Hgerbrandt/mini-pcb/docs/img/poster.png

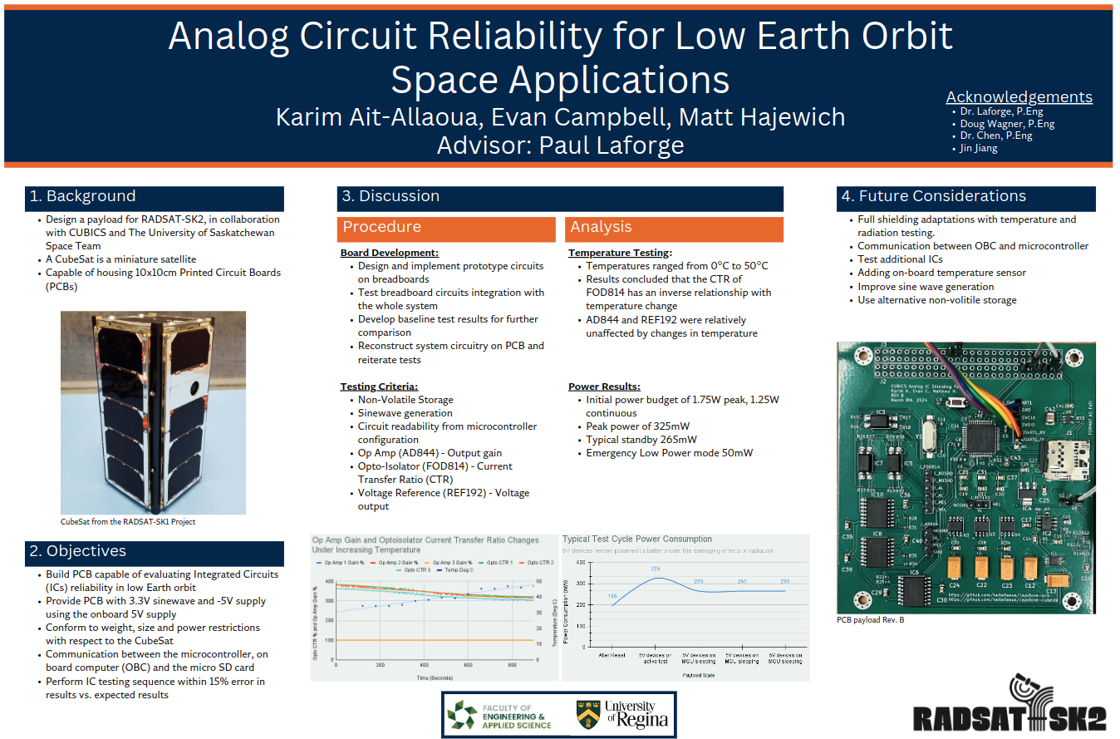
docs/img/poster.png
