Hgerbrandt/mini-pcb/docs/img/back_pcb.png

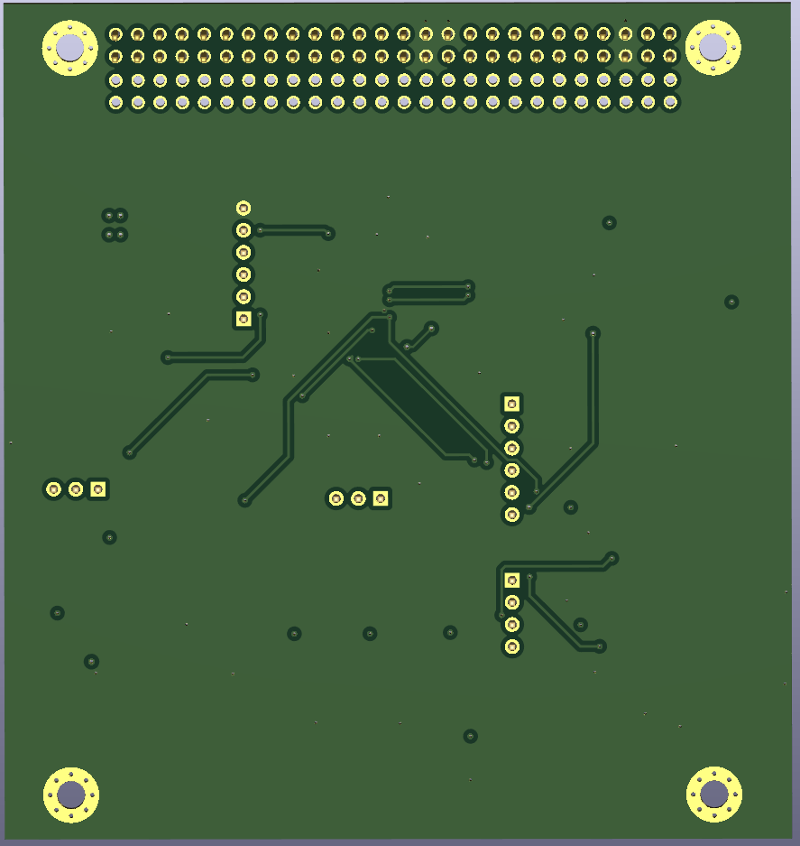
docs/img/back_pcb.png
