Hgerbrandt/mini-pcb/docs/img/front_cu.png

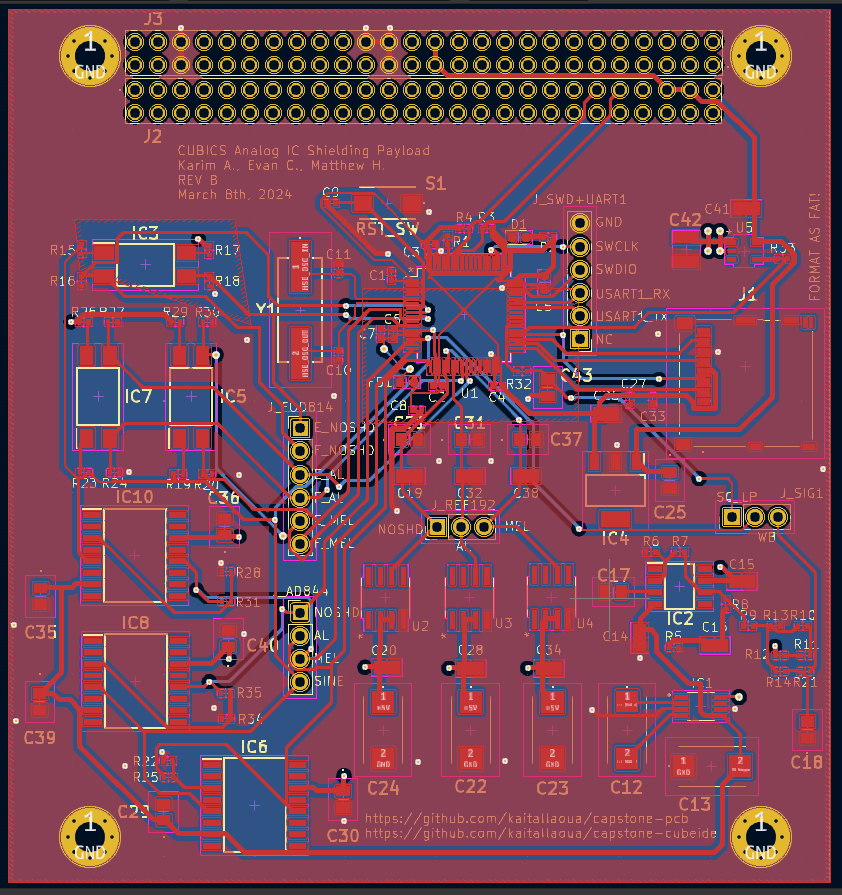
docs/img/front_cu.png
