Hgerbrandt/mini-pcb/docs/img/front_pcb.png

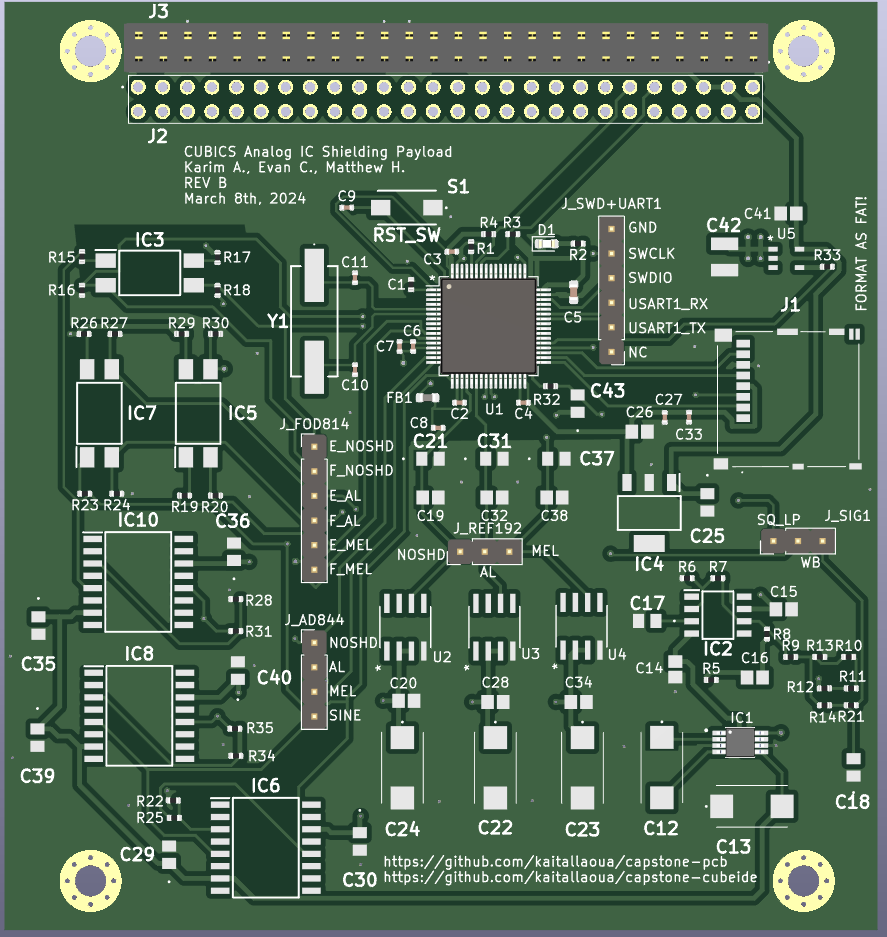
docs/img/front_pcb.png
