Hgerbrandt/mini-pcb/docs/BOM Initial PCB Design - 1st order.pdf

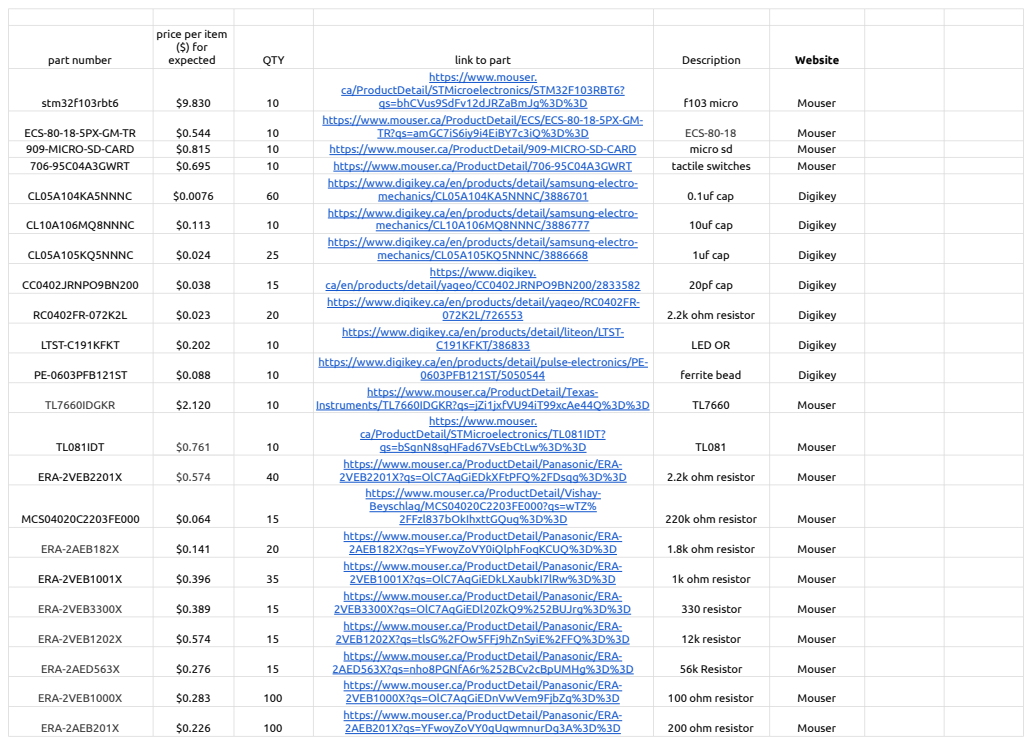
[picture p5: page 1]
part number; QTY; link to part; Description; Website; stm32f103rbt6; qs=bhCVus9SdFv12dJRZaBmJg%3D%3D; f103 micro; Mouser; ECS-80-18-5PX-GM-TR; TR?qs=amGC7iS6iy9i4EiBY7c3iQ%3D%3D; ECS-80-18; 909-MICRO-SD-CARD; https://www.mouser.ca/ProductDetail/909-MICRO-SD-CARD; micro sd; 706-95C04A3GWRT; https://www.mouser.ca/ProductDetail/706-95C04A3GWRT; tactile switches; CL05A104KA5NNNC; mechanics/CL05A104KA5NNNC/3886701; 0.1uf cap; Digikey; CL10A106MQ8NNNC; mechanics/CL10A106MQ8NNNC/3886777; 10uf cap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

price per item
($) for
expected

https://www.mouser.

ca/ProductDetail/STMicroelectronics/STM32F103RBT6?

https://www.mouser.ca/ProductDetail/ECS/ECS-80-18-5PX-GM-

https://www.digikey.ca/en/products/detail/samsung-electro-

https://www.digikey.

https://www.digikey.ca/en/products/detail/yageo/RC0402FR-

https://www.digikey.ca/en/products/detail/liteon/LTST-

https://www.digikey.ca/en/products/detail/pulse-electronics/PE-

https://www.mouser.ca/ProductDetail/Texas-

ca/ProductDetail/STMicroelectronics/TL081IDT?

https://www.mouser.ca/ProductDetail/Panasonic/ERA-
https://www.mouser.ca/ProductDetail/Vishay-
Beyschlag/MCS04020C2203FE000?qs=wTZ%

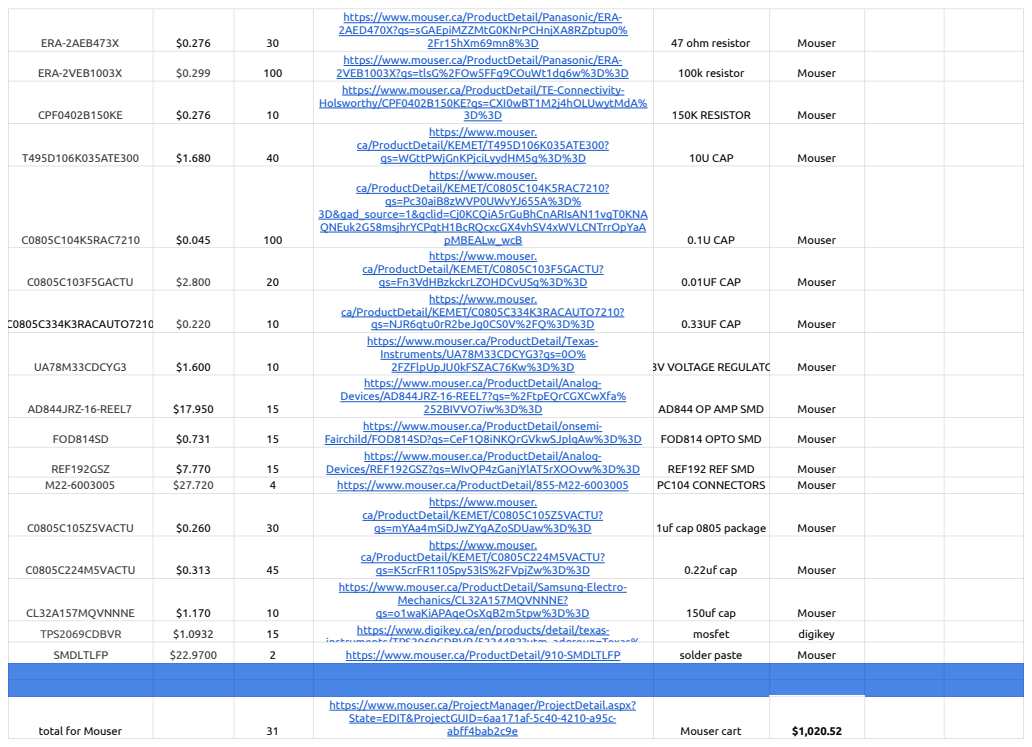
[picture p6: page 2]
ERA-2AEB473X; 2Fr15hXm69mn8%3D; 47 ohm resistor; Mouser; ERA-2VEB1003X; 2VEB1003X?qs=tlsG%2FOw5FFg9COuWt1dq6w%3D%3D; 100k resistor; CPF0402B150KE; 150K RESISTOR; T495D106K035ATE300; qs=WGttPWjGnKPjciLyydHM5g%3D%3D; 10U CAP; C0805C104K5RAC7210; 3D&gad_source=1&gclid=Cj0KCQiA5rGuBhCnARIsAN11vgT0KNA QNEuk2G58msjhrYCPqtH1BcRQcxcGX4vhSV4xWVLCNTrrOpYaA; pMBEALw_wcB; 0.1U CAP; C0805C103F5GACTU; qs=Fn3VdHBzkckrLZOHDCvUSg%3D%3D; 0.01UF CAP; C0805C334K3RACAUTO7210; qs=NJR6qtu0rR2beJg0CS0V%2FQ%3D%3D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

https://www.mouser.ca/ProductDetail/Panasonic/ERA-
2AED470X?qs=sGAEpiMZZMtG0KNrPCHnjXA8RZptup0%

https://www.mouser.ca/ProductDetail/TE-Connectivity-
Holsworthy/CPF0402B150KE?qs=CXI0wBT1M2j4hOLUwytMdA%

https://www.mouser.

ca/ProductDetail/KEMET/T495D106K035ATE300?

ca/ProductDetail/KEMET/C0805C104K5RAC7210?
qs=Pc30aiB8zWVP0UWvYJ655A%3D%

ca/ProductDetail/KEMET/C0805C103F5GACTU?

ca/ProductDetail/KEMET/C0805C334K3RACAUTO7210?
https://www.mouser.ca/ProductDetail/Texas-
Instruments/UA78M33CDCYG3?qs=0O%
https://www.mouser.ca/ProductDetail/Analog-
Devices/AD844JRZ-16-REEL7?qs=%2FtpEQrCGXCwXfa%

https://www.mouser.ca/ProductDetail/onsemi-

ca/ProductDetail/KEMET/C0805C105Z5VACTU?

ca/ProductDetail/KEMET/C0805C224M5VACTU?

https://www.mouser.ca/ProductDetail/Samsung-Electro-

https://www.mouser.ca/ProjectManager/ProjectDetail.aspx?
State=EDIT&ProjectGUID=6aa171af-5c40-4210-a95c-

total for Digikey | 8 | https://www.digikey.ca/short/bmjnbp47 | Digikey cart | 33.18
total cart | 39 | TOTAL | $1,053.70 | Tax might not | be included

https://www.mouser.
ca/ProductDetail/KEMET/C0805C334K3RACAUTO?
qs=sSYV1F9c5cFAGgBePUAC4A%3D%3D (https://www.mouser.ca/ProductDetail/KEMET/C0805C334K3RACAUTO?qs=sSYV1F9c5cFAGgBePUAC4A%3D%3D) | .33uf new
