Hgerbrandt/mini-pcb/footprint_3d/TL7660IDGKR.step

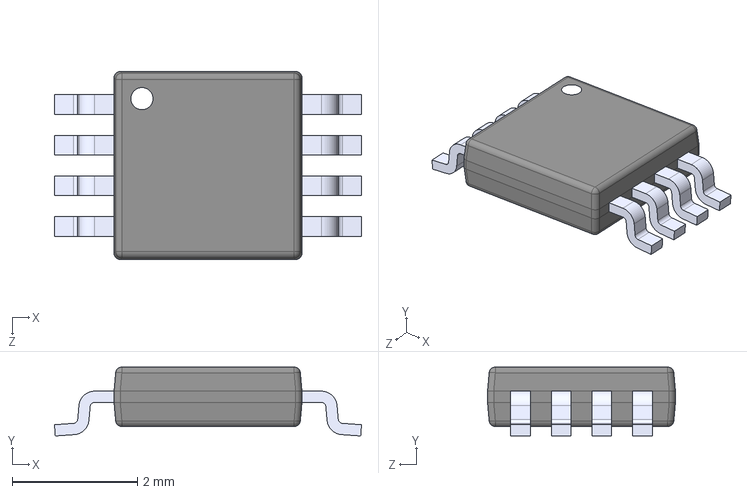
[picture p7: CAD file, 2025-03-23]
footprint_3d/TL7660IDGKR.step
4.90 x 1.10 x 3.00 mm
