Hgerbrandt/mini-pcb/footprint_3d/DBV0005A-MF.stp

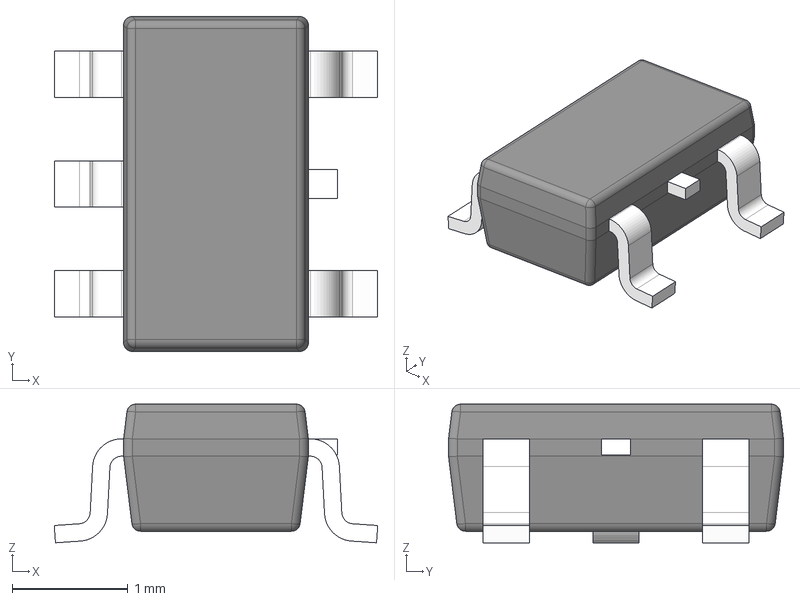
[picture p8: CAD file, 2025-03-23]
footprint_3d/DBV0005A-MF.stp
2.80 x 2.90 x 1.20 mm
BODY-SOT
LEAD-SOT x 5
LEAD-DUMMY
