Hgerbrandt/mini-pcb/footprint_3d/TL081IDT.stp

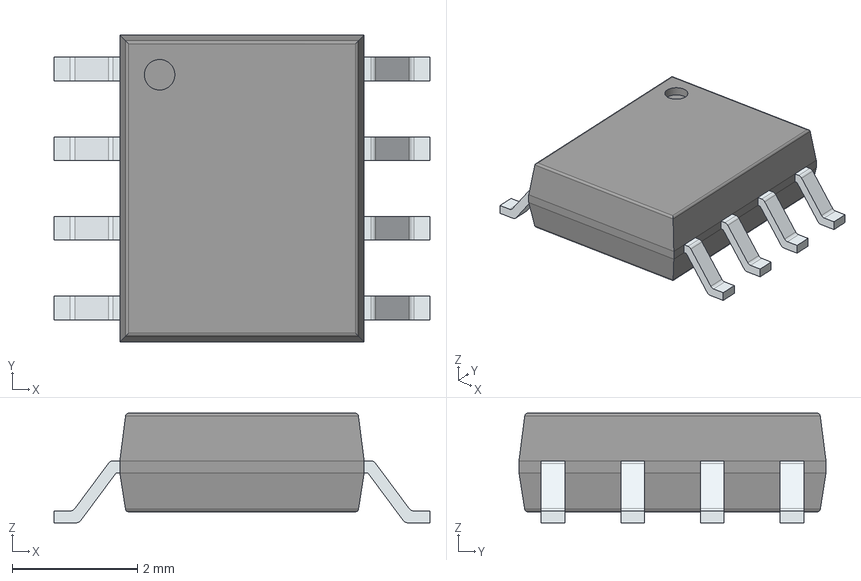
[picture p9: CAD file, 2025-03-23]
footprint_3d/TL081IDT.stp
6.00 x 4.90 x 1.75 mm
PinsArrayLR
