Hgerbrandt/mini-pcb/footprint_3d/ECS-80-18-5PX-GM-TR.stp

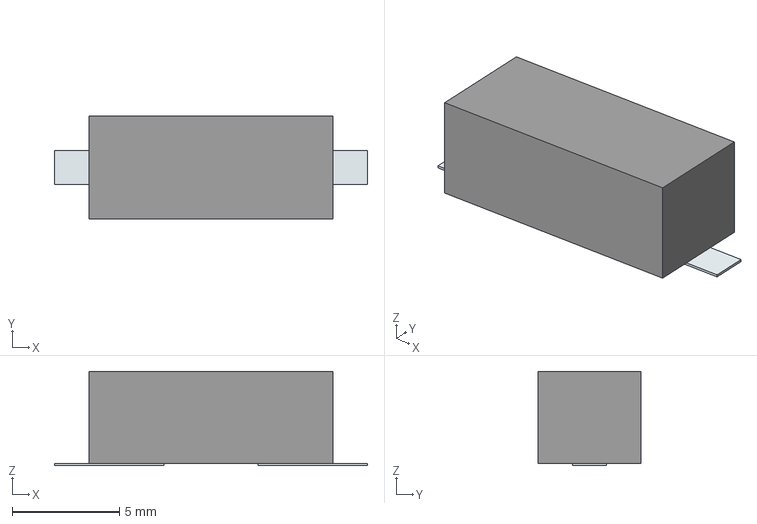
[picture p10: CAD file, 2025-03-23]
footprint_3d/ECS-80-18-5PX-GM-TR.stp
14.6 x 4.80 x 4.40 mm
Pins
