Hgerbrandt/mini-pcb/footprint_3d/MS128-10C.step

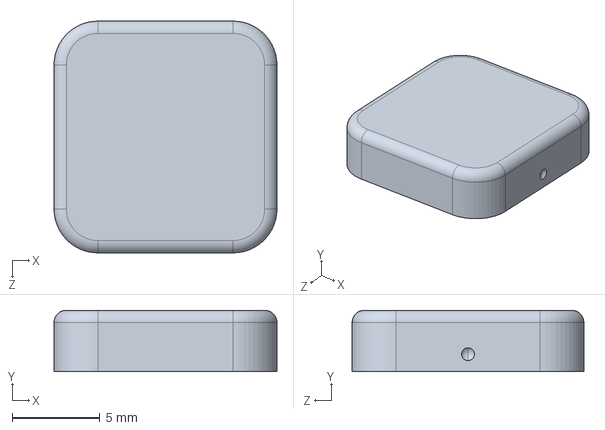
[picture p11: CAD file, 2025-03-23]
footprint_3d/MS128-10C.step
12.7 x 3.50 x 13.2 mm
