Hgerbrandt/mini-pcb/footprint_3d/CAPC220145_88N_KEM.step

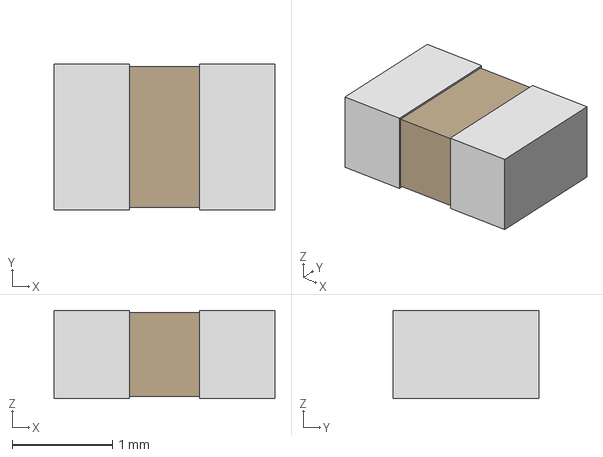
[picture p12: CAD file, 2025-03-23]
footprint_3d/CAPC220145_88N_KEM.step
2.20 x 1.45 x 0.88 mm
