Hgerbrandt/mini-pcb/footprint_3d/ESQ-126-39-L-D.stp

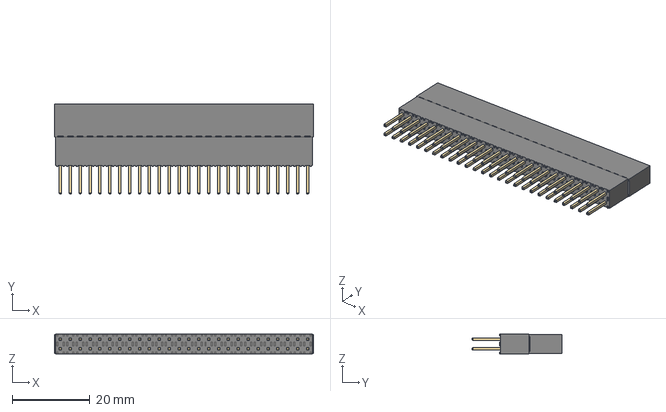
[picture p13: CAD file, 2025-03-23]
footprint_3d/ESQ-126-39-L-D.stp
66.5 x 23.2 x 5.08 mm
