Hgerbrandt/mini-pcb/footprint_3d/T495X106K050ATE250-10u.stp

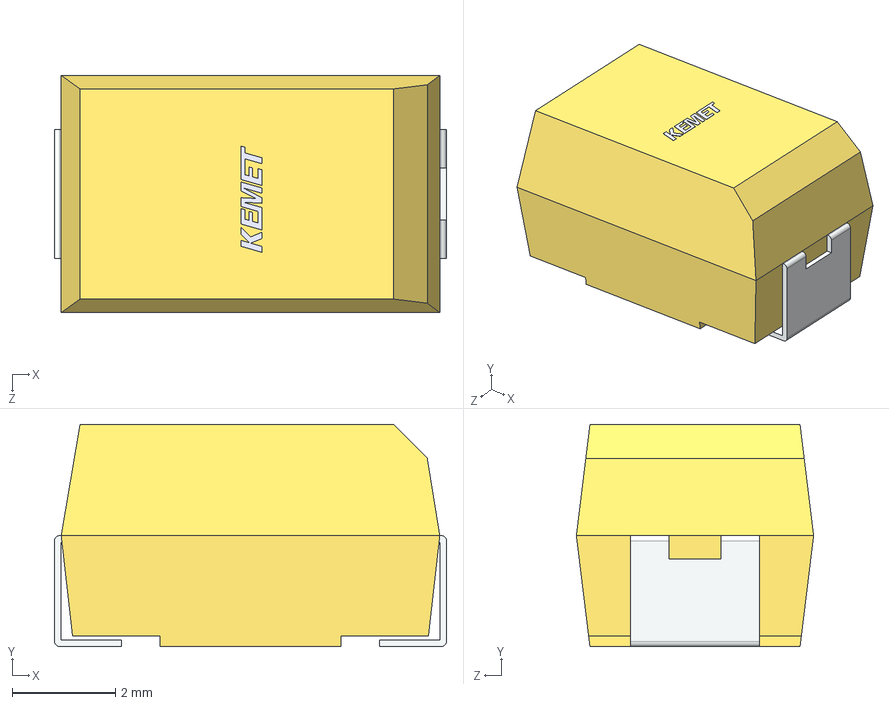
[picture p14: CAD file, 2025-03-23]
footprint_3d/T495X106K050ATE250-10u.stp
7.60 x 4.31 x 4.60 mm
