Hgerbrandt/mini-pcb/footprint_3d/LM35DM.stp

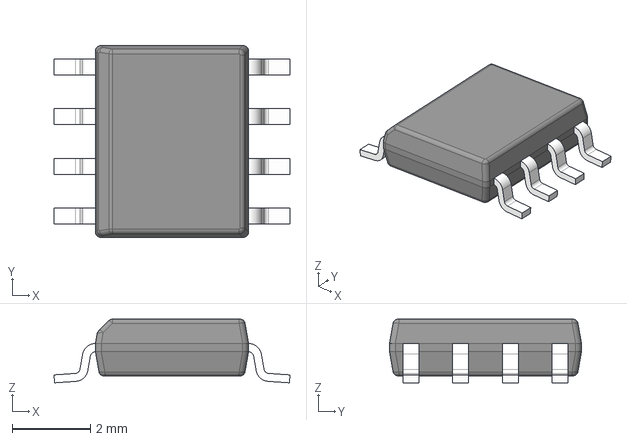
[picture p15: CAD file, 2025-03-23]
footprint_3d/LM35DM.stp
6.02 x 4.90 x 1.63 mm
BODY-SO
LEAD-D0008A x 8
