Hgerbrandt/mini-pcb/footprint_3d/C0805C224M5VACTU-0.22u.stp

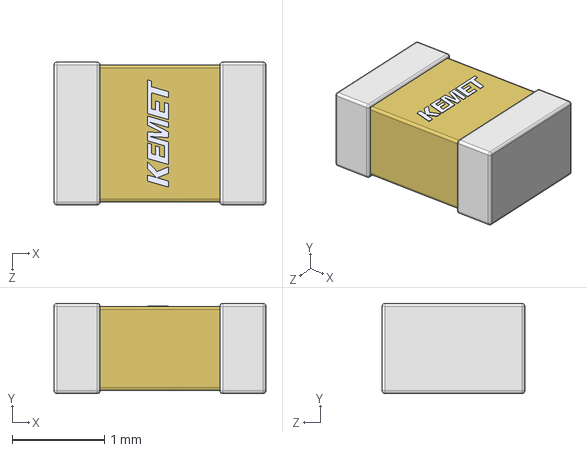
[picture p16: CAD file, 2025-03-23]
footprint_3d/C0805C224M5VACTU-0.22u.stp
2.30 x 0.98 x 1.55 mm
