Hgerbrandt/mini-pcb/footprint_3d/T495D106K035ATE300.stp

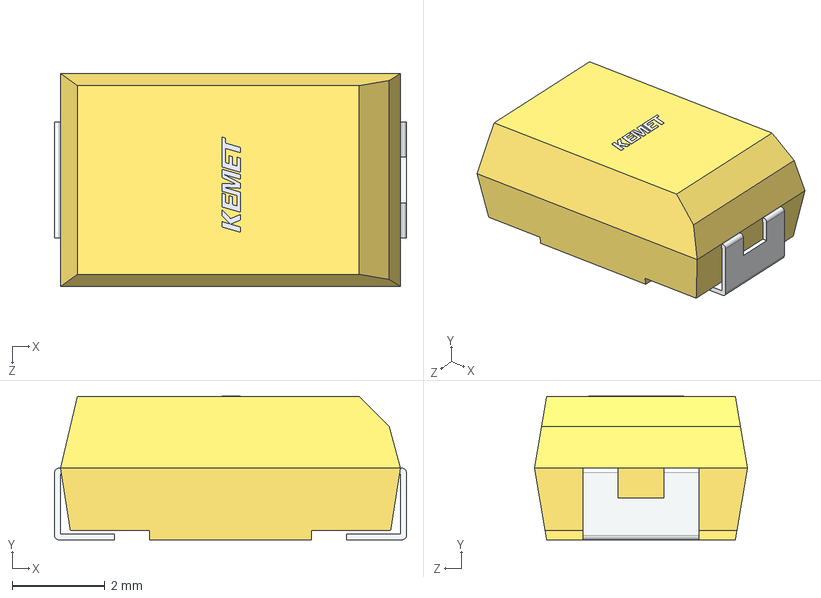
[picture p17: CAD file, 2025-03-23]
footprint_3d/T495D106K035ATE300.stp
7.60 x 3.11 x 4.60 mm
