Hgerbrandt/mini-pcb/footprint_3d/AD844ANZ.stp

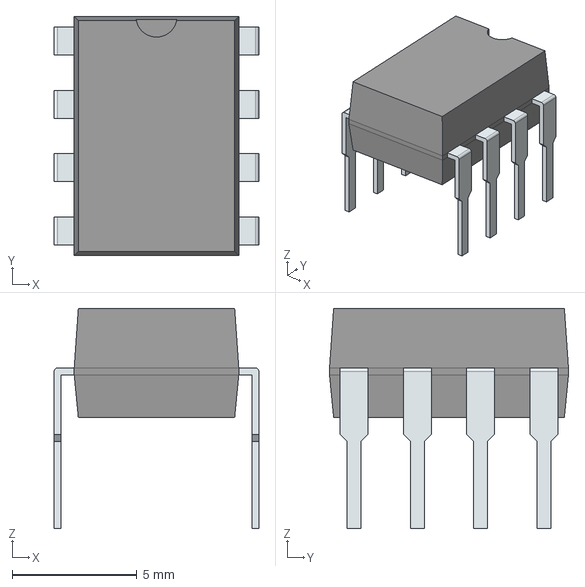
[picture p18: CAD file, 2025-03-23]
footprint_3d/AD844ANZ.stp
8.22 x 9.59 x 8.83 mm
PinsArrayLR
