Hgerbrandt/mini-pcb/footprint_3d/DM3BT_DSF_PEJS.stp

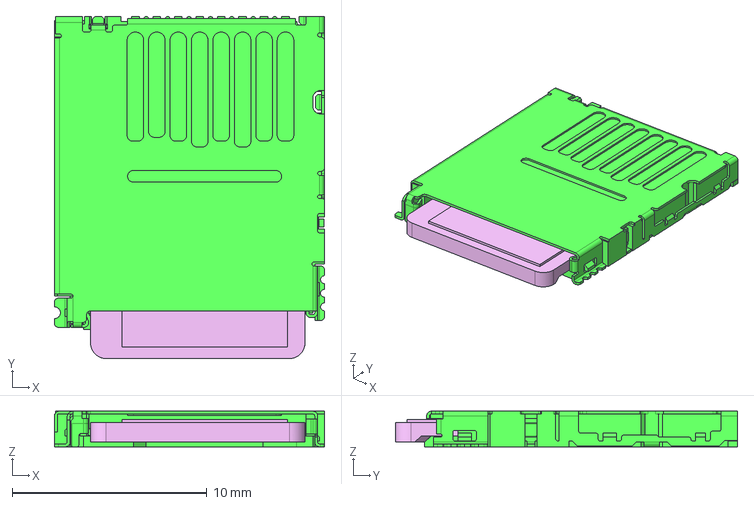
[picture p19: CAD file, 2025-03-23]
footprint_3d/DM3BT_DSF_PEJS.stp
13.8 x 17.6 x 1.83 mm
CARD
DM3BT
