Hgerbrandt/mini-pcb/footprint_3d/C0805C103F5GACTU.stp

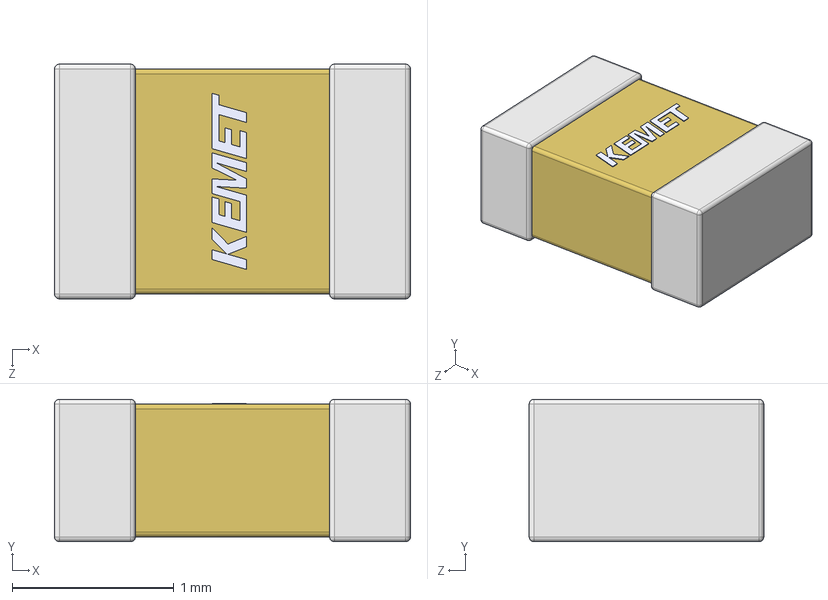
[picture p20: CAD file, 2025-03-23]
footprint_3d/C0805C103F5GACTU.stp
2.20 x 0.88 x 1.45 mm
