Hgerbrandt/mini-pcb/footprint_3d/FOD814SD.stp

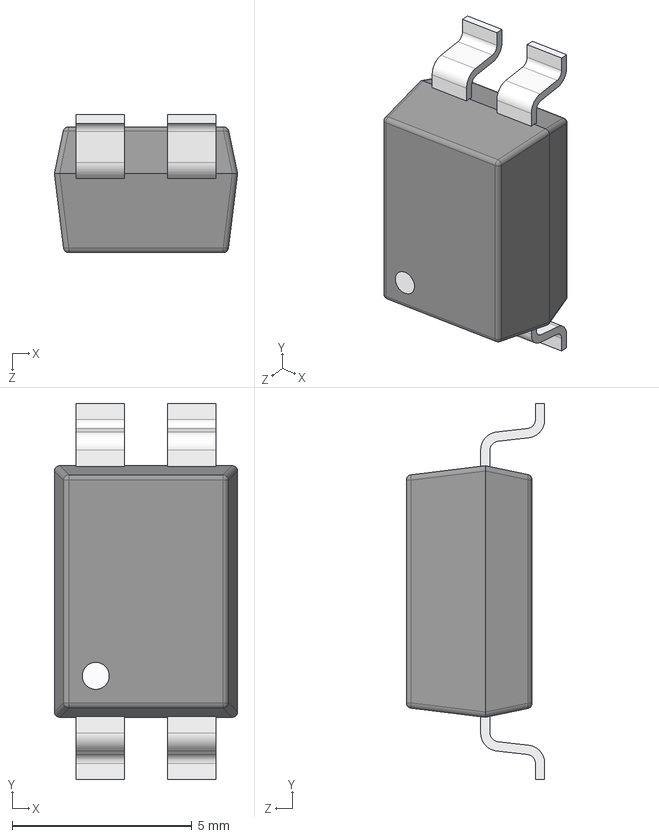
[picture p21: CAD file, 2025-03-23]
footprint_3d/FOD814SD.stp
5.10 x 10.5 x 3.85 mm
