Hgerbrandt/mini-pcb/(list of files, cad)

Other CAD files:
footprint_3d/REF192GSZ.step
