Hgerbrandt/mini-pcb/pcb/mcu_integration.kicad_pcb

## KiCad design pcb/mcu_integration.kicad_pcb (2026-03-15)

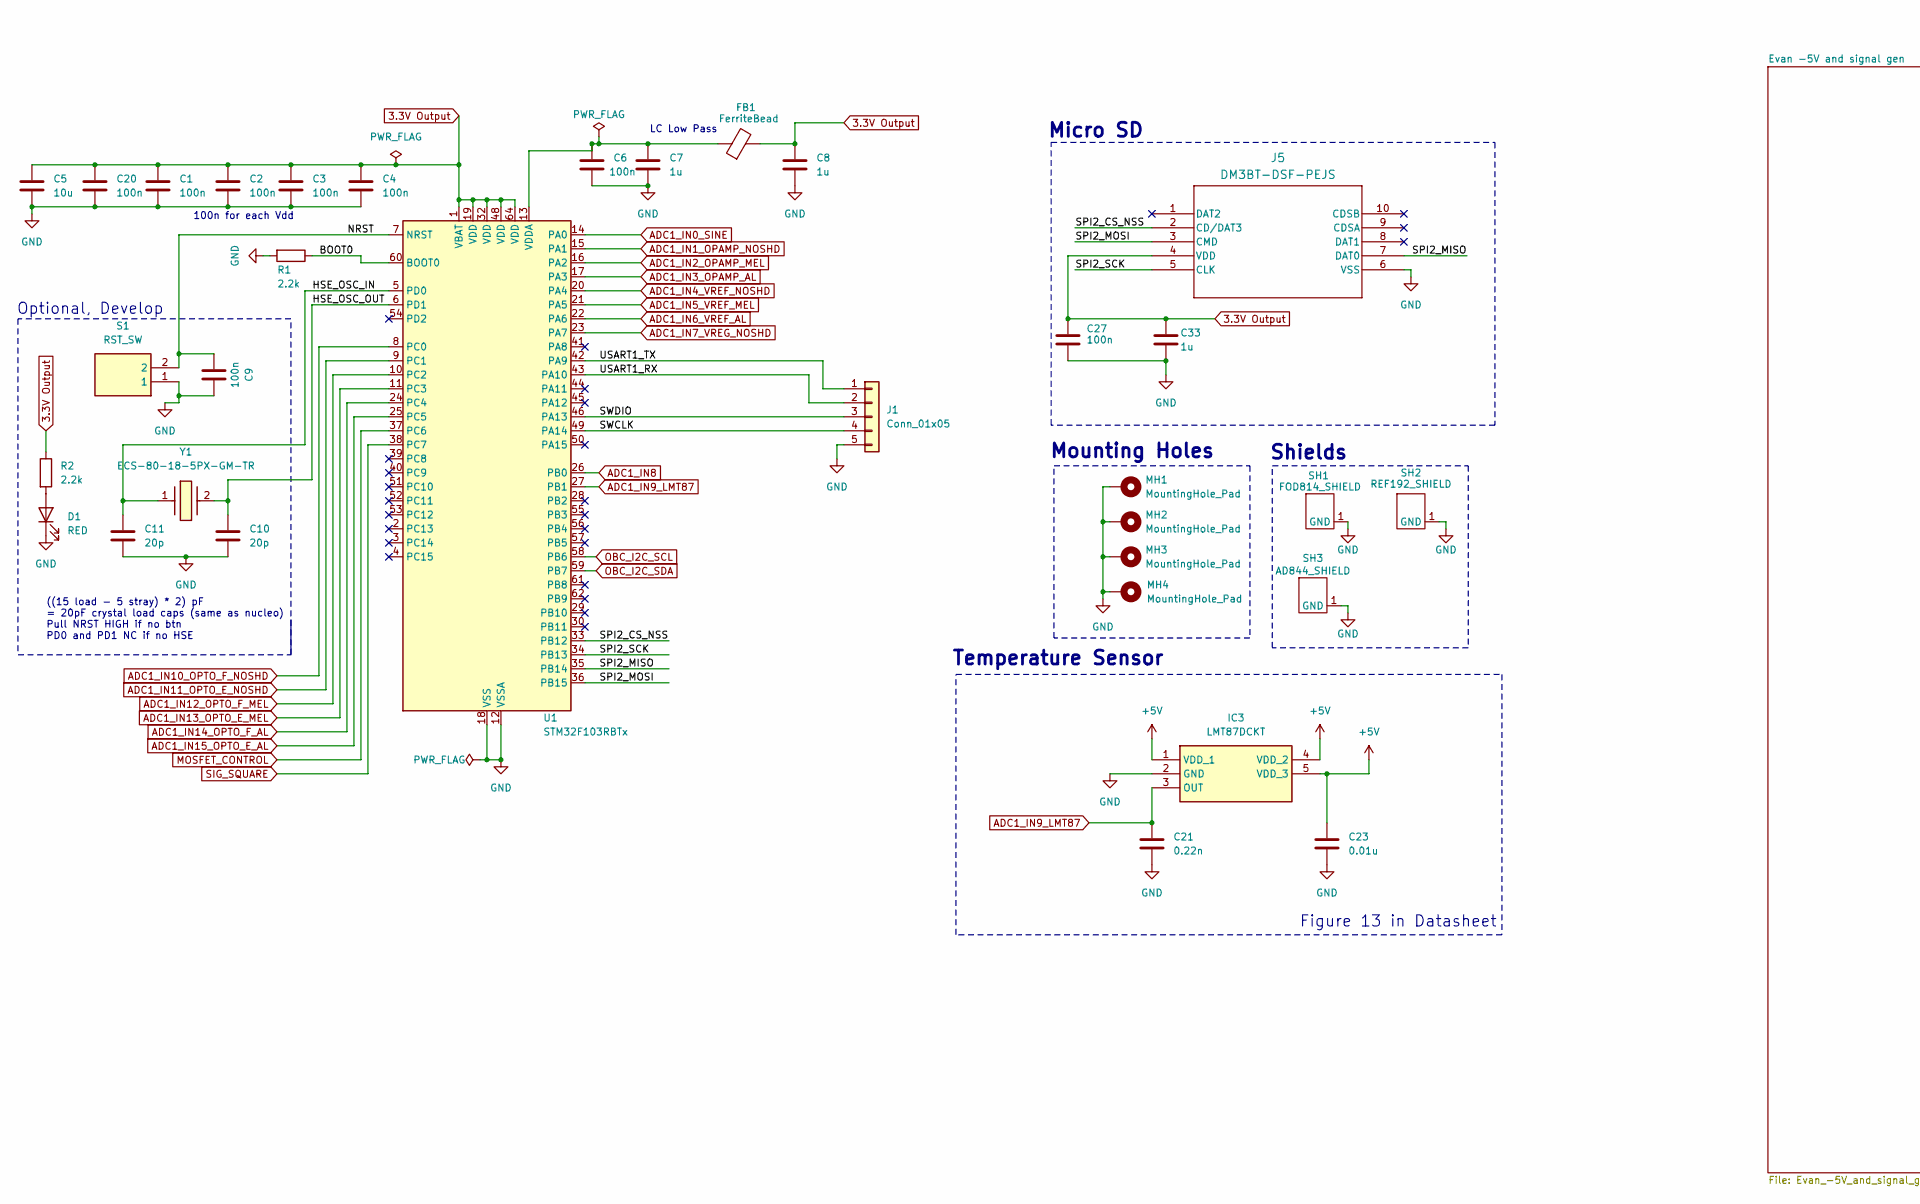
[picture p22: schematic mcu_integration.kicad_sch, Regina Payload Cubesat MCU Integration, part in row 1, column 1]

Parts:
C1, C2, C3, C4, C6, C9, C20, C27: 100n; C_0402_1005Metric
C5: 10u; C_0603_1608Metric
C7, C8, C33: 1u; C_0402_1005Metric
C10, C11: 20p; C_0402_1005Metric
C21: 0.22n; C_0402_1005Metric
C23: 0.01u; C_0402_1005Metric
D1: RED; LED_0603_1608Metric
FB1: FerriteBead; L_0603_1608Metric
IC3: LMT87DCKT; SOT65P210X110-5N; Mouser Part Number 595-LMT87DCKT
J1: Conn_01x05; PinHeader_1x05_P2.54mm_Vertical
J5: DM3BT-DSF-PEJS; DM3BT_DSF_PEJS
MH1, MH2, MH3, MH4: MountingHole_Pad; MountingHole_3.18mm_6.35mm_Pad
R1, R2: 2.2k; R_0402_1005Metric
S1: RST_SW; 95C04A3GWRT; Mouser Part Number 706-95C04A3GWRT
SH1: FOD814_SHIELD; FOD814 Shield
SH2: REF192_SHIELD; REF192 Shield
SH3: AD844_SHIELD; AD844 Shield
U1: STM32F103RBTx; LQFP-64_10x10mm_P0.5mm
Y1: ECS-80-18-5PX-GM-TR; ECS80185PXGMTR; Mouser Part Number 520-80-18-5PX-GM-TR

Connections:
3.3V Output: C1.1, C2.1, C3.1, C4.1, C5.1, C8.1, C20.1, C27.1, C33.1, FB1.2, J5.4 (VDD), R2.1, U1.1 (VBAT), U1.19 (VDD), U1.32 (VDD), U1.48 (VDD), U1.64 (VDD); also elsewhere on the board
+5V: C23.1, IC3.1 (VDD_1), IC3.4 (VDD_2), IC3.5 (VDD_3); also elsewhere on the board
/BOOT0: R1.1, U1.60 (BOOT0)
/HSE_OSC_IN: C11.1, U1.5 (PD0), Y1.1
/HSE_OSC_OUT: C10.1, U1.6 (PD1), Y1.2
/NRST: C9.2, S1.2, U1.7 (NRST)
/SPI2_CS_NSS: J5.2 (CD/DAT3), U1.33 (PB12)
/SPI2_MISO: J5.7 (DAT0), U1.35 (PB14)
/SPI2_MOSI: J5.3 (CMD), U1.36 (PB15)
/SPI2_SCK: J5.5 (CLK), U1.34 (PB13)
/SWCLK: J1.4, U1.49 (PA14)
/SWDIO: J1.3, U1.46 (PA13)
/USART1_RX: J1.2, U1.43 (PA10)
/USART1_TX: J1.1, U1.42 (PA9)
ADC1_IN0_SINE: U1.14 (PA0); also elsewhere on the board
ADC1_IN1_OPAMP_NOSHD: U1.15 (PA1)
ADC1_IN2_OPAMP_MEL: U1.16 (PA2)
ADC1_IN3_OPAMP_AL: U1.17 (PA3); also elsewhere on the board
ADC1_IN4_VREF_NOSHD: U1.20 (PA4)
ADC1_IN5_VREF_MEL: U1.21 (PA5)
ADC1_IN6_VREF_AL: U1.22 (PA6); also elsewhere on the board
ADC1_IN7_VREG_NOSHD: U1.23 (PA7)
ADC1_IN8: U1.26 (PB0)
ADC1_IN9_LMT87: C21.1, IC3.3 (OUT), U1.27 (PB1)
ADC1_IN10_OPTO_F_NOSHD: U1.8 (PC0)
ADC1_IN11_OPTO_E_NOSHD: U1.9 (PC1)
ADC1_IN12_OPTO_F_MEL: U1.10 (PC2)
ADC1_IN13_OPTO_E_MEL: U1.11 (PC3)
ADC1_IN14_OPTO_F_AL: U1.24 (PC4); also elsewhere on the board
ADC1_IN15_OPTO_E_AL: U1.25 (PC5); also elsewhere on the board
GND: C1.2, C2.2, C3.2, C4.2, C5.2, C6.2, C7.2, C8.2, C9.1, C10.2, C11.2, C20.2, C21.2, C23.2, C27.2, C33.2, D1.1 (K), IC3.2 (GND), J1.5, J5.6 (VSS), MH1.1, MH2.1, MH3.1, MH4.1, R1.2, S1.1, SH1.1 (GND), SH2.1 (GND), SH3.1 (GND), U1.12 (VSSA), U1.18 (VSS), U1.31 (VSS), U1.47 (VSS), U1.63 (VSS); also elsewhere on the board
MOSFET_CONTROL: U1.37 (PC6)
unnamed: D1.2 (A), R2.2
unnamed: C6.1, C7.1, FB1.1, U1.13 (VDDA)
OBC_I2C_SCL: U1.58 (PB6); also elsewhere on the board
OBC_I2C_SDA: U1.59 (PB7); also elsewhere on the board
SIG_SQUARE: U1.38 (PC7); also elsewhere on the board

Notes on the sheet:
((15 load - 5 stray) * 2) pF = 20pF crystal load caps (same as nucleo) Pull NRST HIGH if no btn PD0 and PD1 NC if no HSE
Mounting Holes
Micro SD
Optional, Develop
Temperature Sensor
100n for each Vdd
Shields
Figure 13 in Datasheet
LC Low Pass

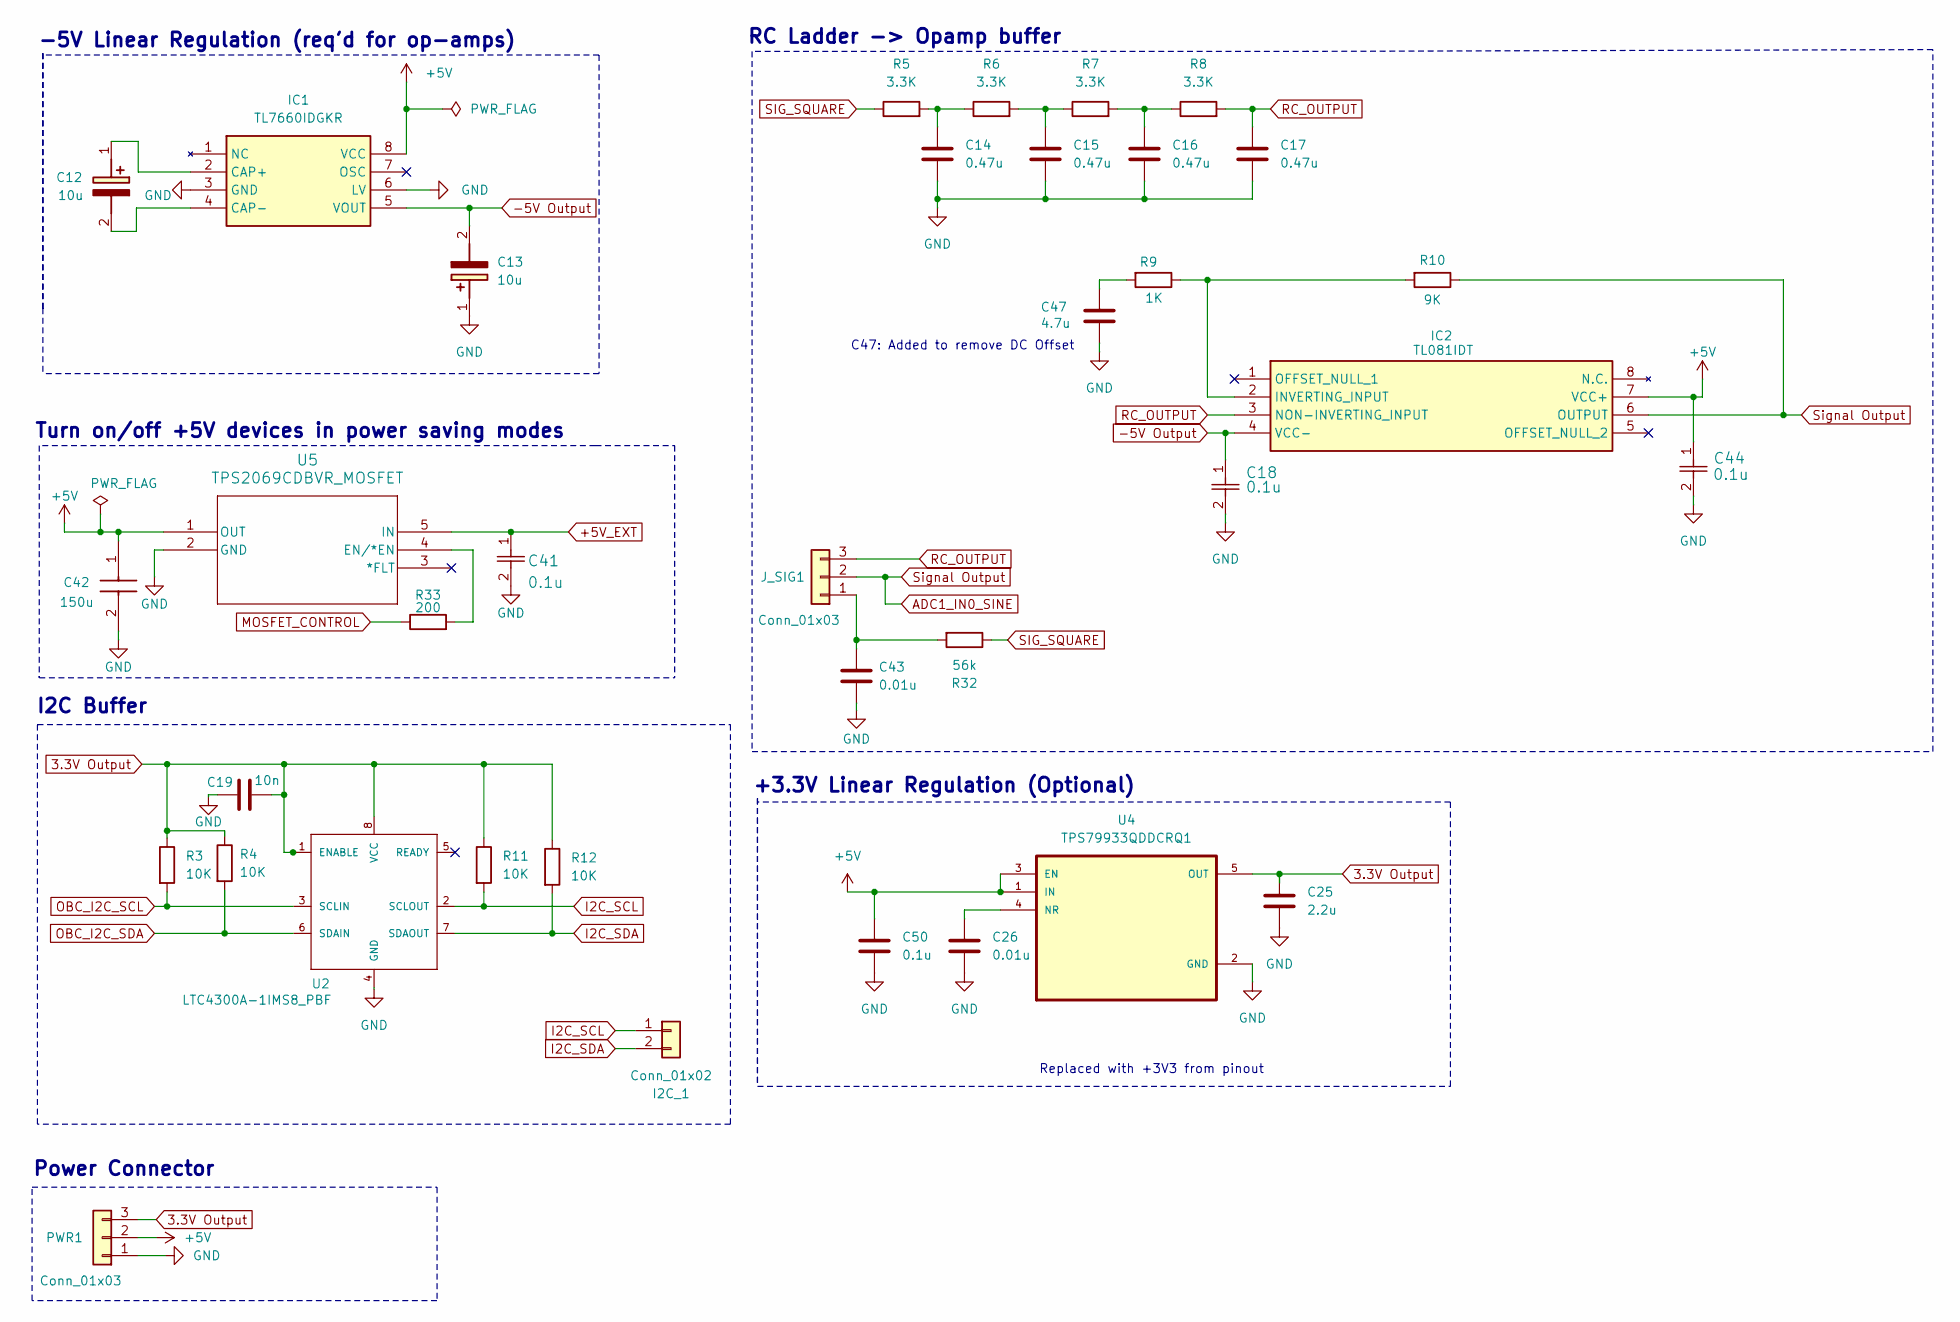
[picture p23: schematic Evan_-5V_and_signal_gen.kicad_sch, Power and Sine Generator]

Parts:
C12, C13: 10u; C_0805_2012Metric; Mouser Part Number 80-T495D106K035
C14, C15, C16, C17: 0.47u; C_0402_1005Metric
C18: 0.1u; C_0805_2012Metric
C19: 10n; C_0402_1005Metric
C25: 2.2u; C_0402_1005Metric
C26, C43: 0.01u; C_0402_1005Metric
C41, C44: 0.1u; CAPC220145_88N_KEM-0.1u
C42: 150u; CAPC3225X280N_150U; Mouser Part Number 187-CL32A157MQVNNNE
C47: 4.7u; C_0402_1005Metric
C50: 0.1u; C_0402_1005Metric
I2C_1: Conn_01x02; PinHeader_1x02_P2.54mm_Vertical
IC1: TL7660IDGKR; SOP65P490X110-8N-actual; Mouser Part Number 595-TL7660IDGKR
IC2: TL081IDT; SOIC127P600X175-8N; Mouser Part Number 511-TL081IDT
J_SIG1: Conn_01x03; PinHeader_1x03_P2.54mm_Vertical
PWR1: Conn_01x03; PinHeader_1x03_P2.54mm_Vertical
R3, R4, R11, R12: 10K; R_0402_1005Metric
R5, R6, R7, R8: 3.3K; R_0402_1005Metric
R9: 1K; R_0402_1005Metric
R10: 9K; R_0402_1005Metric
R32: 56k; R_0402_1005Metric
R33: 200; R_0402_1005Metric
U2: LTC4300A-1IMS8_PBF; MANUFACTURER_PART_NUMBER ltc4300a1ims8
U4: TPS79933QDDCRQ1; SOT95P280X110-5N
U5: TPS2069CDBVR_MOSFET; DBV5_TEX_MF

Connections:
3.3V Output: C19.2, C25.1, PWR1.3, R3.1, R4.1, R11.1, R12.1, U2.1 (ENABLE), U2.8 (VCC), U4.5 (OUT); also elsewhere on the board
+5V: C42.1, C44.1, C50.1, IC1.8 (VCC), IC2.7 (VCC+), PWR1.2, U4.1 (IN), U4.3 (EN), U5.1 (OUT); also elsewhere on the board
-5V Output: C13.2 (-), C18.1, IC1.5 (VOUT), IC2.4 (VCC-); also elsewhere on the board
ADC1_IN0_SINE: IC2.6 (OUTPUT), J_SIG1.2, R10.1; also elsewhere on the board
GND: C13.1 (+), C14.2, C15.2, C16.2, C17.2, C18.2, C19.1, C25.2, C26.2, C41.2, C42.2, C43.1, C44.2, C47.2, C50.2, IC1.3 (GND), IC1.6 (LV), PWR1.1, U2.4 (GND), U4.2 (GND), U5.2 (GND); also elsewhere on the board
I2C_SCL: I2C_1.1, R11.2, U2.2 (SCLOUT)
I2C_SDA: I2C_1.2, R12.2, U2.7 (SDAOUT)
unnamed: C12.1 (+), IC1.2 (CAP+)
unnamed: C12.2 (-), IC1.4 (CAP-)
unnamed: C14.1, R5.2, R6.1
unnamed: C15.1, R6.2, R7.1
unnamed: C16.1, R7.2, R8.1
unnamed: C41.1, U5.5 (IN)
unnamed: C47.1, R9.2
unnamed: IC2.2 (INVERTING_INPUT), R9.1, R10.2
unnamed: C43.2, J_SIG1.1, R32.2
unnamed: R33.2, U5.4 (EN/*EN)
unnamed: C26.1, U4.4 (NR)
OBC_I2C_SCL: R3.2, U2.3 (SCLIN); also elsewhere on the board
OBC_I2C_SDA: R4.2, U2.6 (SDAIN); also elsewhere on the board
RC_OUTPUT: C17.1, IC2.3 (NON-INVERTING_INPUT), J_SIG1.3, R8.2
SIG_SQUARE: R5.1, R32.1; also elsewhere on the board

Notes on the sheet:
+3.3V Linear Regulation (Optional)
-5V Linear Regulation (req'd for op-amps)
C47: Added to remove DC Offset
Power Connector
RC Ladder -> Opamp buffer
I2C Buffer
Turn on/off +5V devices in power saving modes
Replaced with +3V3 from pinout

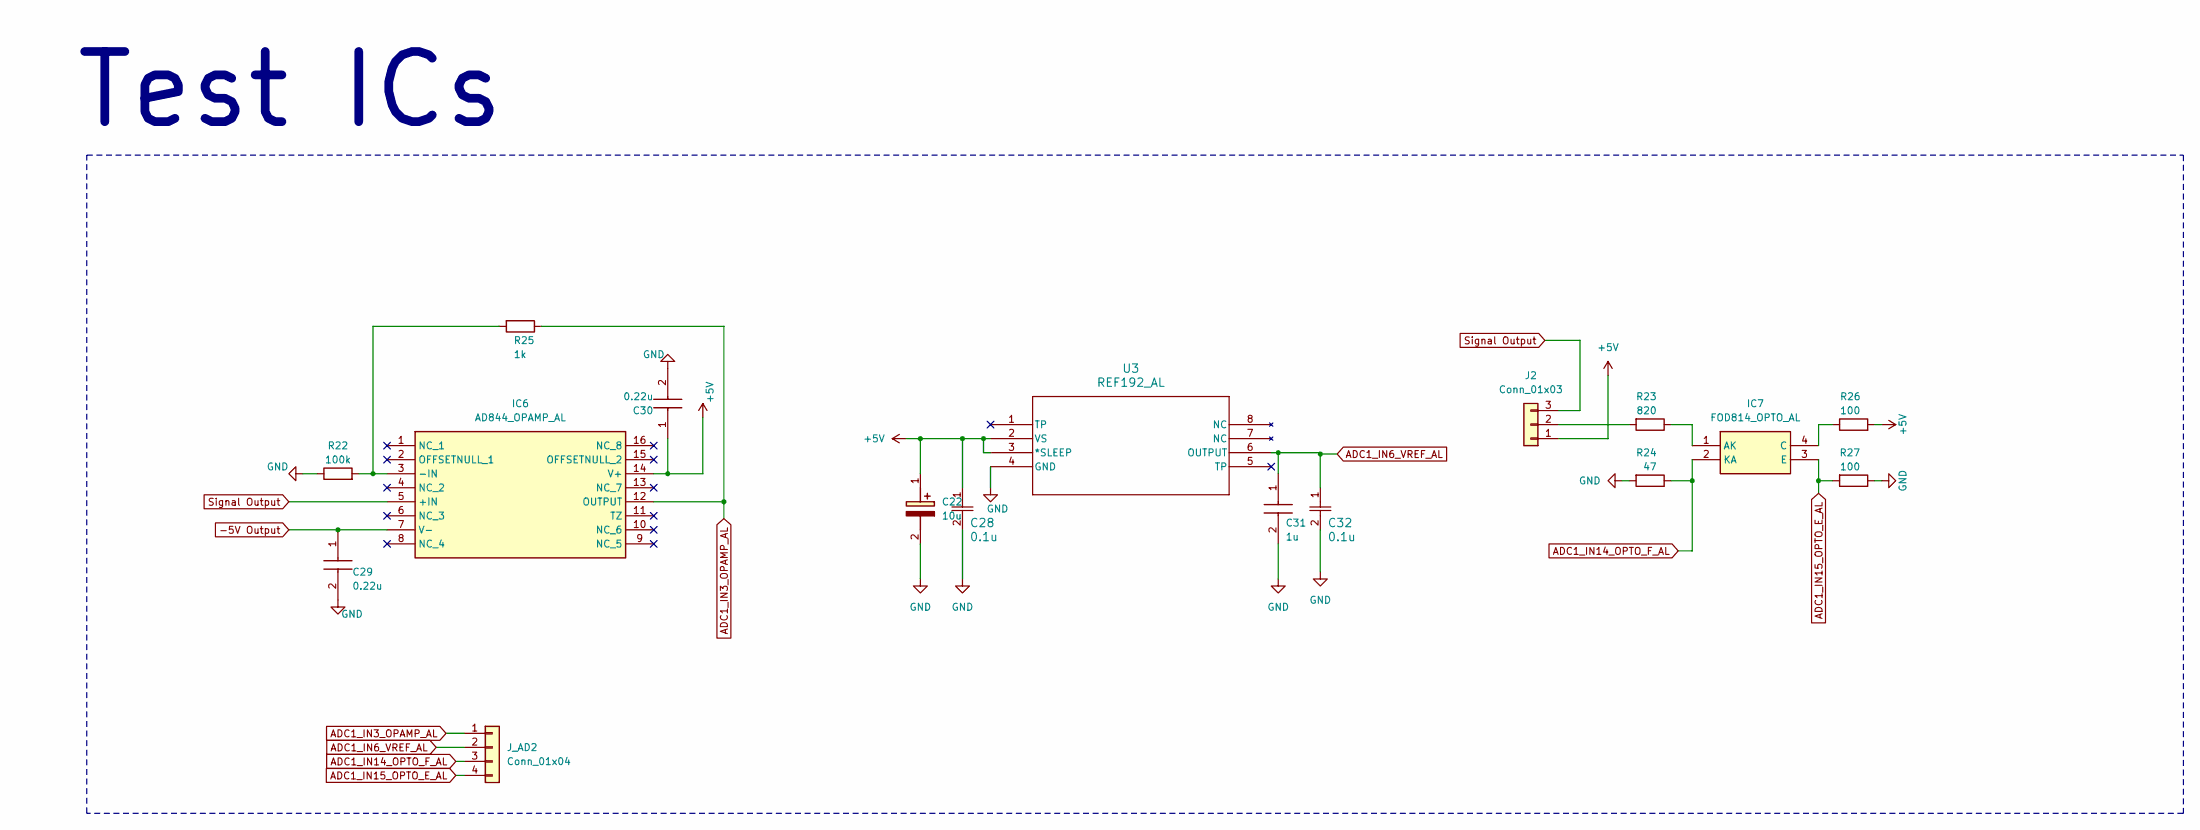
[picture p24: schematic untitled.kicad_sch, REF192-AD844-FOD814 Testing Circuits]

Parts:
C22: 10u; C_0805_2012Metric; Mouser Part Number 80-T495D106K035
C28, C32: 0.1u; CAPC220145_88N_KEM-0.1u
C29, C30: 0.22u; C0805-0.22u; Manufacturer_Part_Number C0805C224M5VACTU
C31: 1u; C0805-1u; Mouser Part Number 80-C0805C105Z5VACTU
IC6: AD844_OPAMP_AL; SOIC127P1032X265-16N-AD844; Mouser Part Number 584-AD844JRZ-16-R7
IC7: FOD814_OPTO_AL; SOP254P1016X385-4N-FOD; Mouser Part Number 512-FOD814SD
J2: Conn_01x03; PinHeader_1x03_P2.54mm_Vertical
J_AD2: Conn_01x04; PinHeader_1x04_P2.54mm_Vertical
R22: 100k; R_0402_1005Metric
R23: 820; R_0402_1005Metric
R24: 47; R_0402_1005Metric
R25: 1k; R_0402_1005Metric
R26, R27: 100; R_0402_1005Metric
U3: REF192_AL; R_8_ADI-REF

Connections:
+5V: C22.1 (+), C28.1, C30.1, IC6.14 (V+), J2.1, R26.2, U3.2 (VS), U3.3 (*SLEEP); also elsewhere on the board
-5V Output: C29.1, IC6.7 (V-); also elsewhere on the board
ADC1_IN0_SINE: IC6.5 (+IN), J2.3; also elsewhere on the board
ADC1_IN3_OPAMP_AL: IC6.12 (OUTPUT), J_AD2.1, R25.1; also elsewhere on the board
ADC1_IN6_VREF_AL: C31.1, C32.1, J_AD2.2, U3.6 (OUTPUT); also elsewhere on the board
ADC1_IN14_OPTO_F_AL: IC7.2 (KA), J_AD2.3, R24.1; also elsewhere on the board
ADC1_IN15_OPTO_E_AL: IC7.3 (E), J_AD2.4, R27.2; also elsewhere on the board
GND: C22.2 (-), C28.2, C29.2, C30.2, C31.2, C32.2, R22.1, R24.2, R27.1, U3.4 (GND); also elsewhere on the board
unnamed: IC6.3 (-IN), R22.2, R25.2
unnamed: IC7.1 (AK), R23.1
unnamed: IC7.4 (C), R26.1
unnamed: J2.2, R23.2

Notes on the sheet:
Test ICs

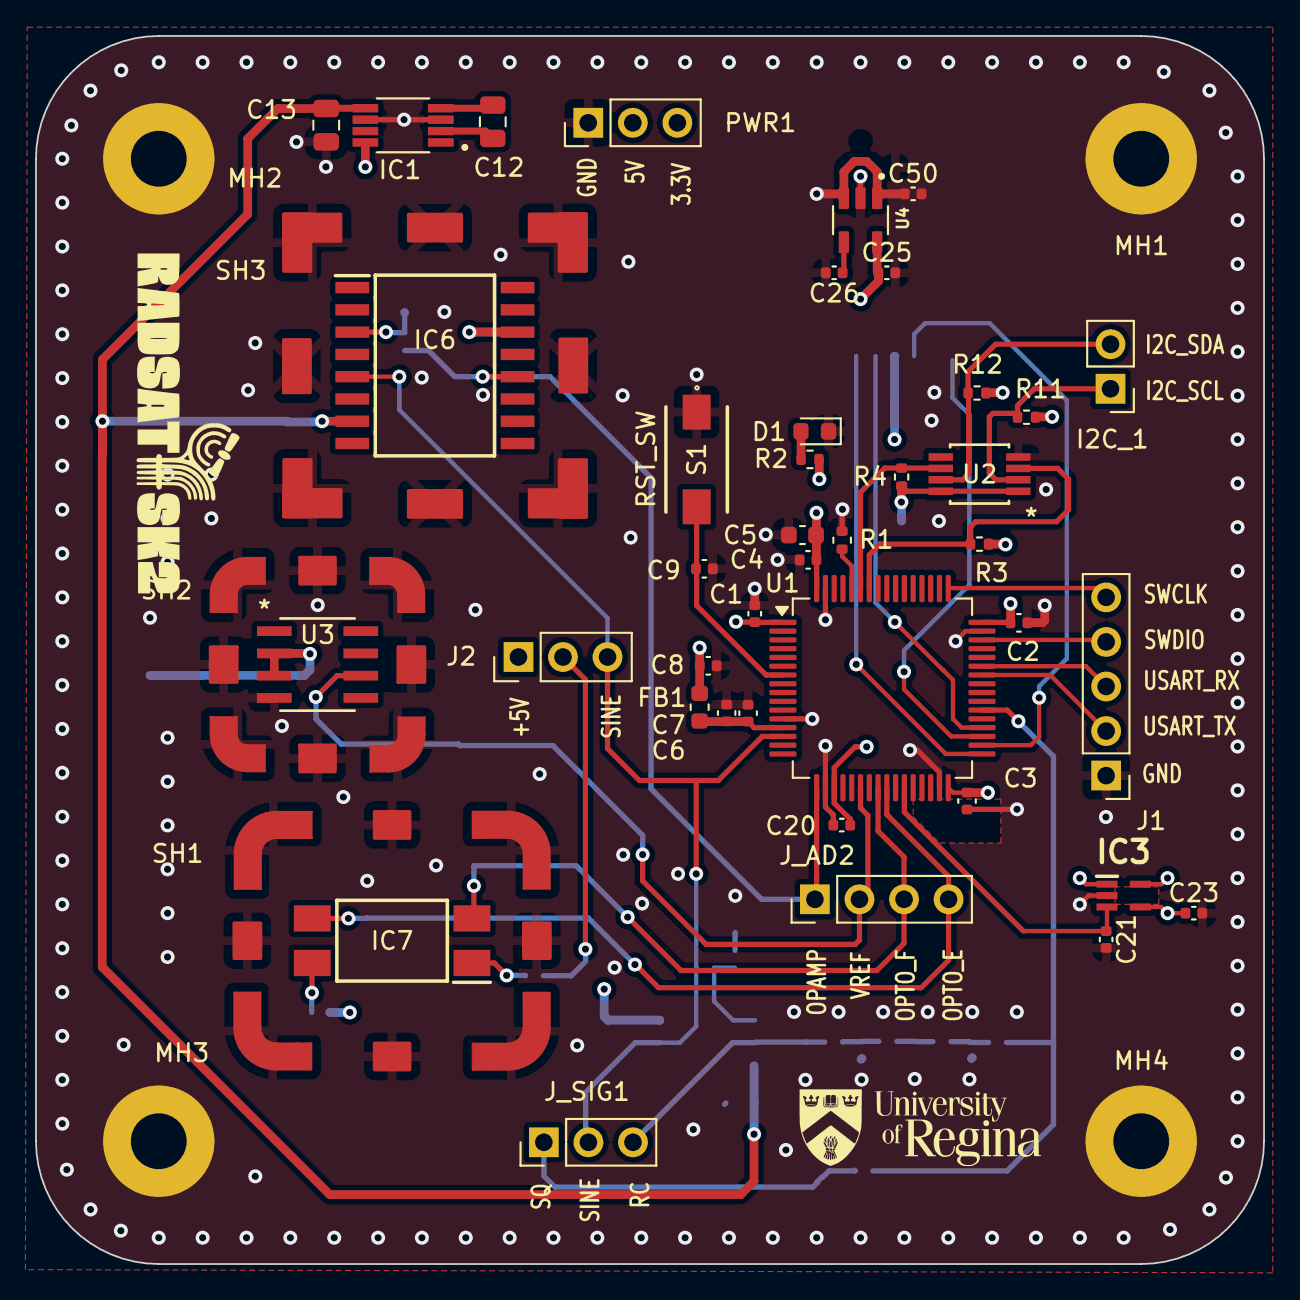
[picture p25: board mcu_integration.kicad_pcb from above]

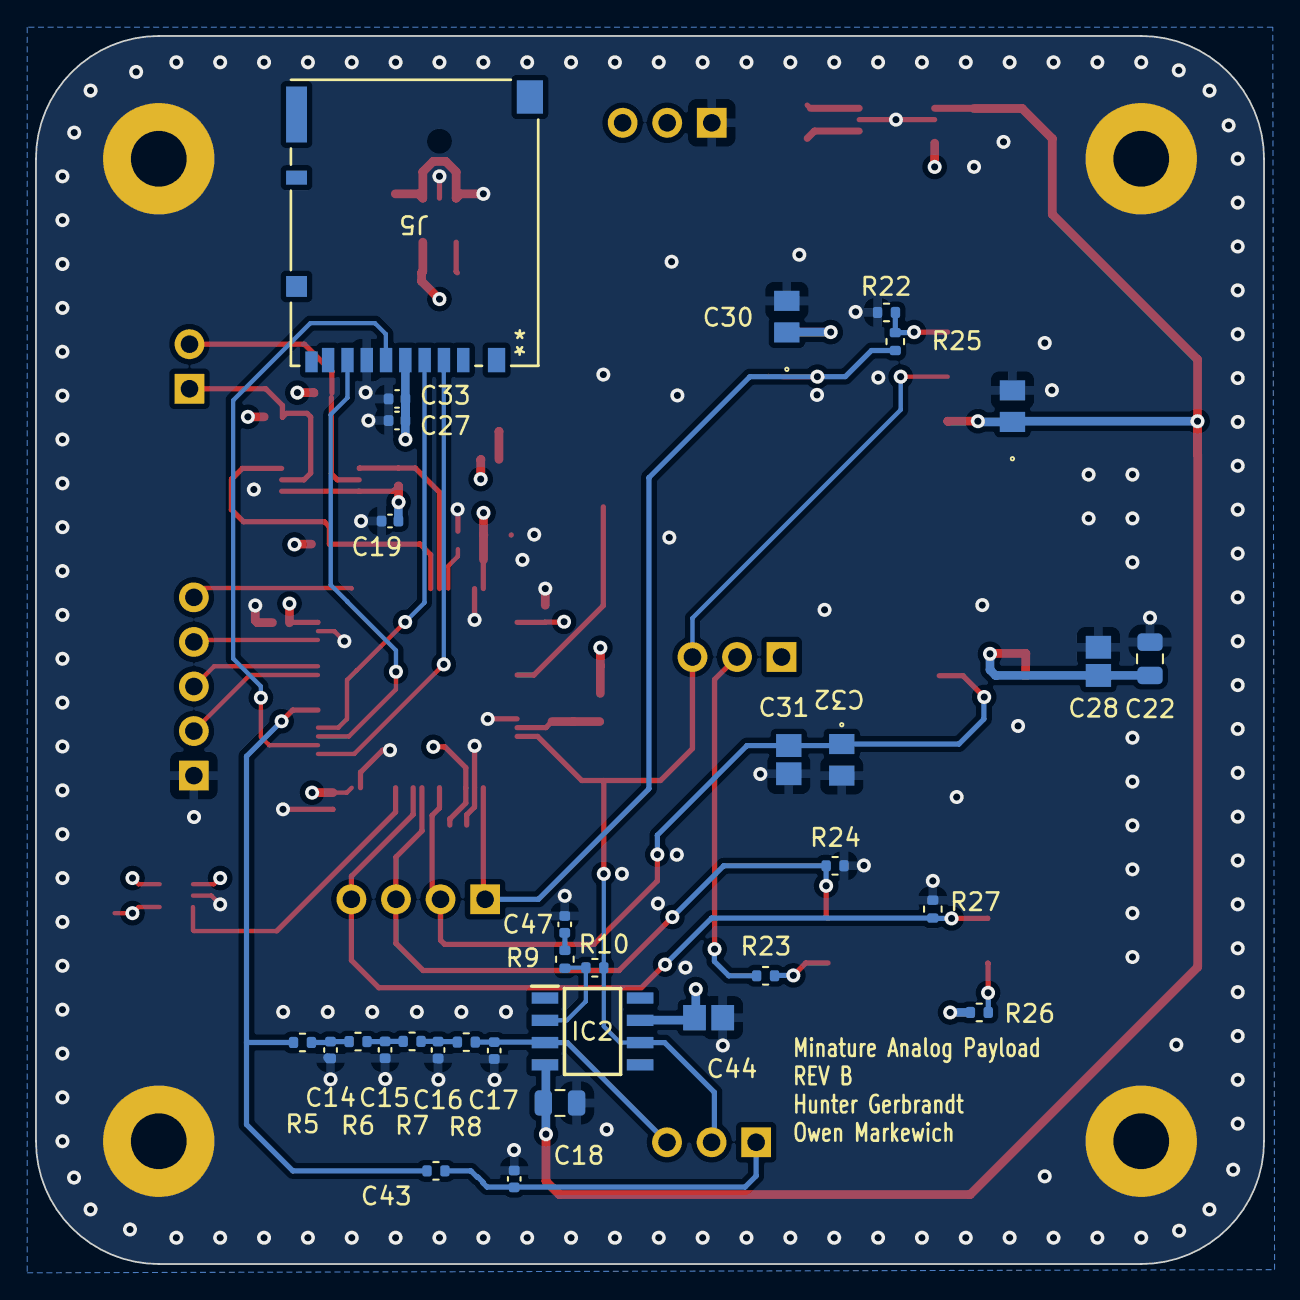
[picture p26: board mcu_integration.kicad_pcb from below]

Board: 4 copper layers, 70.0 x 70.0 mm, 79 parts (36 on the bottom side), 41 nets.
