Hgerbrandt/mini-pcb/(commit log)

2025-03-23 Added PCB Files
    [AD844ANZ.stp, C0805C103F5GACTU.stp, C0805C105Z5VACTU-1u.stp, C0805C224M5VACTU-0.22u.stp, CAPC220145_88N_KEM.step, DBV0005A-MF.stp, DM3BT_DSF_PEJS.stp, ECS-80-18-5PX-GM-TR.stp]
2025-03-30 Restructured PCB
    [Evan_-5V_and_signal_gen.kicad_sch, mcu_integration.kicad_pcb, mcu_integration.kicad_sch]
2025-03-30 Arranged components to fit board
    [mcu_integration.kicad_pcb]
2025-03-31 Added two pin connector, routed all connections
    [mcu_integration.kicad_pcb]
2025-03-31 Added I2C Connector
    [Evan_-5V_and_signal_gen.kicad_sch, mcu_integration.kicad_pcb]
2025-04-06 Increased board size from 5x5 to 7x7
    [mcu_integration.kicad_pcb, mcu_integration.kicad_sch]
2025-05-11 Added reset button & LED, fixed SD card overhang
    [Evan_-5V_and_signal_gen.kicad_sch, mcu_integration.kicad_pcb]
2025-05-18 Added non-inverting amplifier
    [Evan_-5V_and_signal_gen.kicad_sch, mcu_integration.kicad_pcb, mcu_integration.kicad_sch, untitled.kicad_sch]
2025-05-19 Changed spacing between test ICs
    [mcu_integration.kicad_pcb]
2025-05-25 changed 5 volt nets from 0.25mm to 0.5mm
    [mcu_integration.kicad_pcb]
2025-05-25 Fixed pin labels
    [mcu_integration.kicad_pcb]
2025-05-25 Ran DFM and made adjustments accordingly
    [mcu_integration.kicad_pcb]
2025-06-27 changed footprints and layout
    [Evan_-5V_and_signal_gen.kicad_sch, mcu_integration.kicad_pcb, mcu_integration.kicad_sch, untitled.kicad_sch]
2025-08-17 Added Shields
    [Evan_-5V_and_signal_gen.kicad_sch, mcu_integration.kicad_pcb, mcu_integration.kicad_sch, untitled.kicad_sch]
2025-08-24 Adjusted Silkscreen
    [mcu_integration.kicad_pcb]
2025-08-31 Fixed Footprints
    -Added Solder Mask
    -Symbol Pin Numbers
    [mcu_integration.kicad_pcb, mcu_integration.kicad_sch]
2025-11-23 Added capacitor to op amp circuit
    [Evan_-5V_and_signal_gen.kicad_sch, mcu_integration.kicad_pcb]
2025-12-08 Added switchable input for opto-coupler
    [Evan_-5V_and_signal_gen.kicad_sch, mcu_integration.kicad_pcb, untitled.kicad_sch]
2026-01-11 Changed IC test orientation
    [mcu_integration.kicad_pcb, mcu_integration.kicad_sch]
2026-01-16 Thermal Reliefs for Shields
    [Evan_-5V_and_signal_gen.kicad_sch, mcu_integration.kicad_pcb]
2026-02-04 Replaced LM35 temp sensor with LMT87
    [mcu_integration.kicad_pcb, mcu_integration.kicad_sch]
2026-03-15 Added 3V3 linear voltage regulator
    [Evan_-5V_and_signal_gen.kicad_sch, mcu_integration.kicad_pcb]
2026-06-21 Updated BOM
    [Evan_-5V_and_signal_gen.kicad_sch, mcu_integration.kicad_sch, untitled.kicad_sch]
